junya28nya/PhysicalFlick/readme.md

# 物理フリックキーボード

スマホの文字入力で一般的に使われているフリック入力を行える物理キーボード。

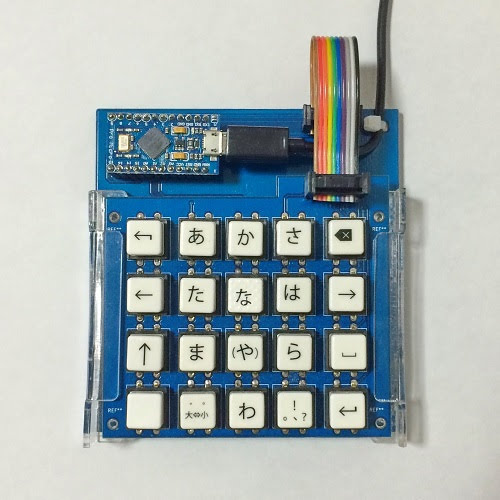
[picture p1: manual/Resources/a_00.jpg]
物理フリックの画像


- [物理フリックキーボード使用動画](https://youtu.be/PQrwTX5ErzM)
## 仕様
- ボタンの押下と上下左右のフリック方向から、かなの入力が行えます。
- アルファベットの入力はできません。Arduinoのプログラムを変更することでアルファベットの入力をできるようにすることは可能です。
- 半角全角の切り替えはできません。使用にはPCのキーボードで全角モードに切り替える必要があります。

### 各キーの説明
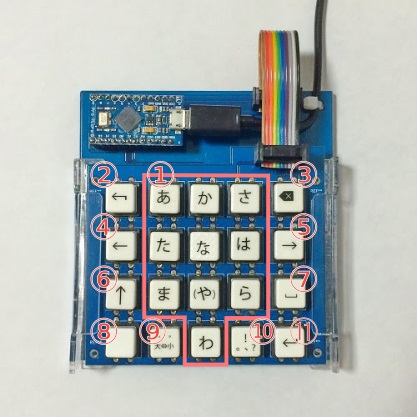
[picture p2: manual/Resources/a_01.jpg]
各キーの説明


|||||
|---|---|---|---|
|①|かな入力をおこなうキー|②|母音を戻るキー。例：い→あ→お|
|③|バックスペース|④|←矢印キー|
|⑤|→矢印キー|⑥|↑矢印キー|
|⑦|スペースキー|⑧|顔文字キー|
|⑨|大小文字切り替えキー|⑩|。、！？キー|
|⑪|Enterキー|　|　|

## development
[development](https://github.com/junya28nya/PhysicalFlick/blob/master/development/development.md)  
プログラム、回路図について。

## manual
[組み立て方](https://github.com/junya28nya/PhysicalFlick/blob/master/manual/HowtoAssembly.md)  
組み立て方について。
