junya28nya/PhysicalFlick/development/development.md

使用マイコン：Pro-micro

## プログラム
[flick.ino](https://github.com/junya28nya/PhysicalFlick/blob/master/development/flick/flick.ino):メインプログラム  
[func.ino](https://github.com/junya28nya/PhysicalFlick/blob/master/development/flick/func.ino):関数群  

## 回路図
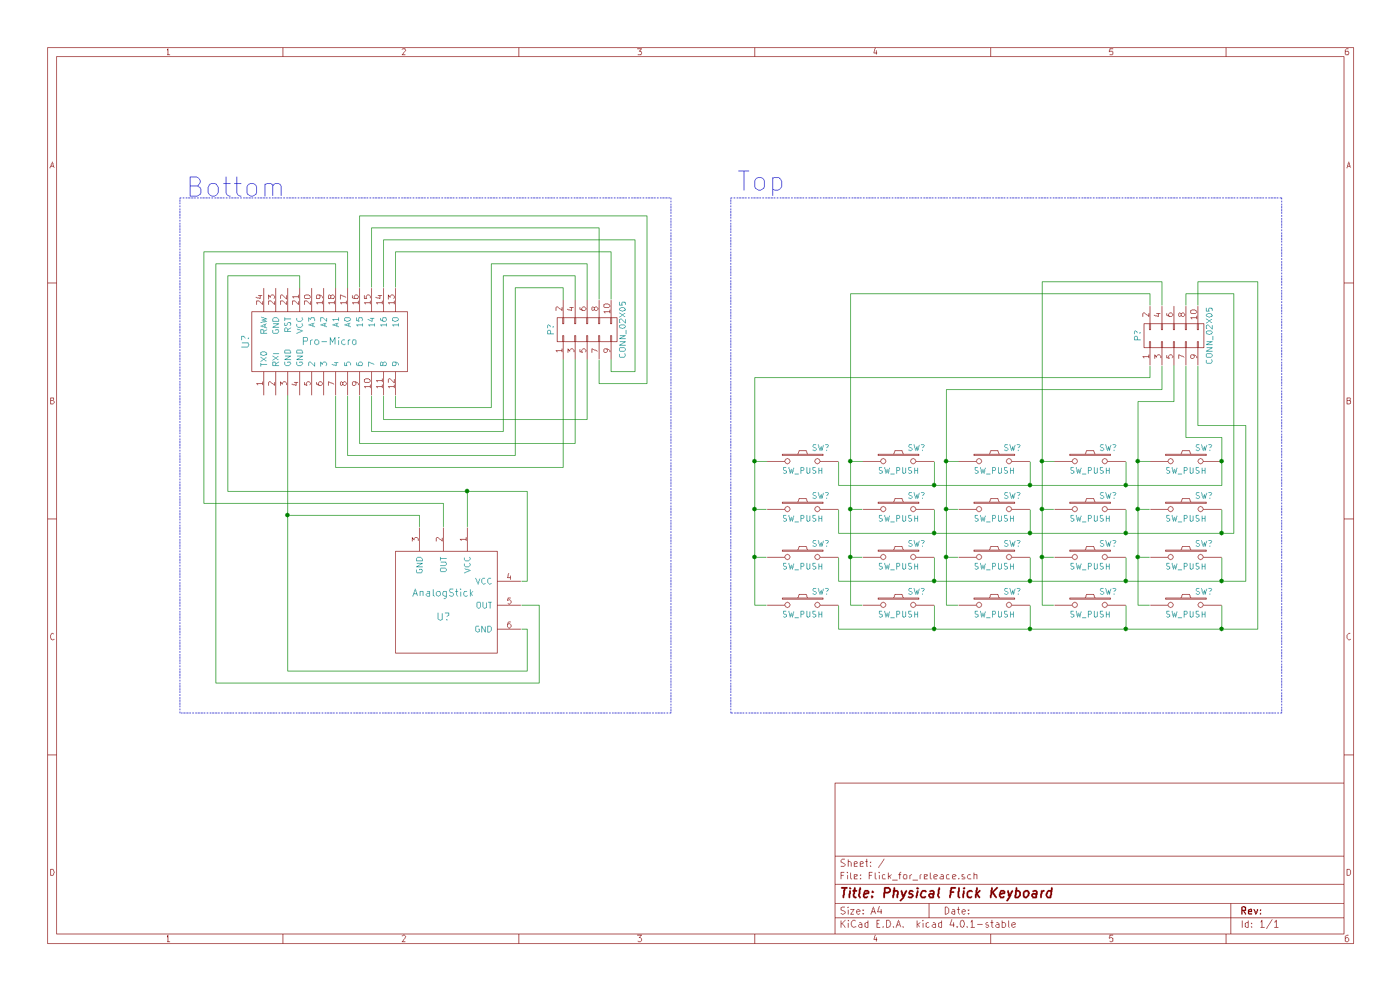
[picture p3: development/Resources/circuit.png]
回路
