junya28nya/PhysicalFlick/manual/HowtoAssembly.md

# 物理フリックキーボード組み立て手順

[仕様や各キーの説明についてはこちら](https://github.com/junya28nya/PhysicalFlick/blob/master/readme.md)

## 注意点
基板の側面が鋭くなっている可能性があります。気になる場合はやすり削ってください。  
電子部品は静電気に弱いため、作業前に手を洗う等静電気を除去してください。  
細かい部品があります。紛失しないように注意してください。

## 準備するするもの
- はんだ付けに必要なもの一式
- プラスドライバー

## 内容物の確認
以下の部品がすべてそろっているか確認してから組み立ててください。

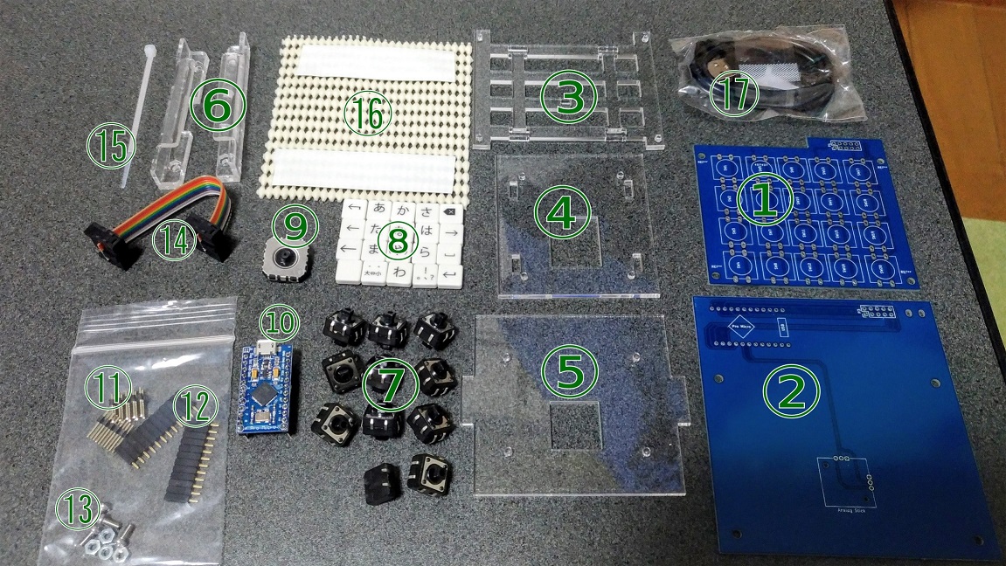
[picture p4: manual/Resources/01.jpg]
内容物一覧


①基板(上)  ②基板(下)  ③フリック機構(上)  ④フリック機構(中)  ⑤フリック機構(下) ⑥サイドパーツ(2つ)  ⑦スイッチ(20個)  ⑧スイッチカバー(20個) ⑨アナログスティック  ⑩pro-micro(マイコン)  ⑪2×5ピンヘッダ(2つ) ⑫1×12ピンソケット(2つ) ⑬ねじとナット(4つ) ⑭コネクタ ⑮結束バンド  ⑯滑り止め ⑰USBケーブル

## 組み立て作業
### ①基板(上)のはんだ付け
- 使用する部品
  - ①基板(上)、⑦スイッチ、⑧スイッチカバー、⑪2×5ピンヘッダ(1つ)

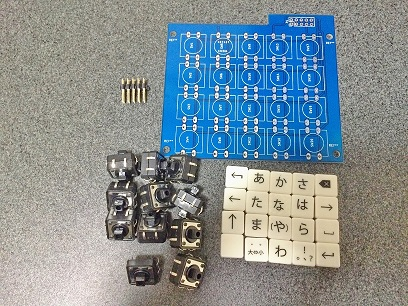
[picture p5: manual/Resources/02_01.jpg]
①基板(上)のはんだ付け部品


| | |
|---|---|
|||
|1-1　スイッチのはんだ付け <br>⑦スイッチを①基板(上)に差し込む <br>　|1-2　裏面 <br> スイッチの足はおらないように注意 <br> (③フリック機構(上)に干渉してしまう)|
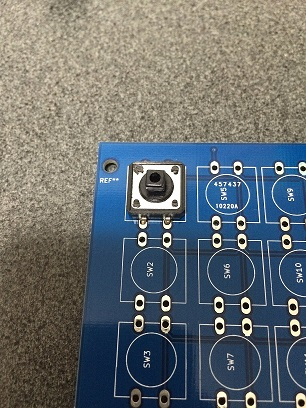
[picture p6: manual/Resources/02_02.jpg]
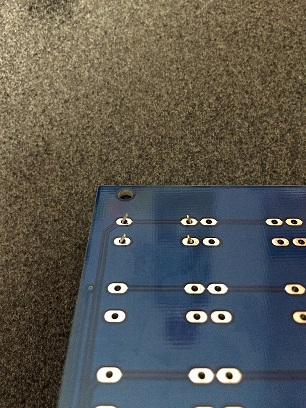
[picture p7: manual/Resources/02_03.jpg]
|||
|1-3 <br> すべてのスイッチを差し込んでから、裏面にはんだ付けを行う|1-4　⑪2×5ピンヘッダのはんだ付け <br> 傾かないように確認しはんだ付けを行う|
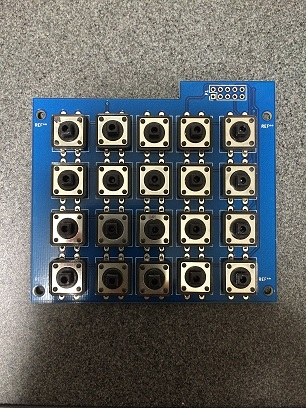
[picture p8: manual/Resources/02_04.jpg]
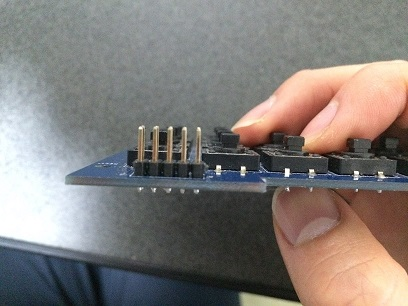
[picture p9: manual/Resources/02_05.jpg]
|||
|1-5 はんだ付け後の画像 <br> 表面|1-6 はんだ付け後の画像 <br> 裏面|
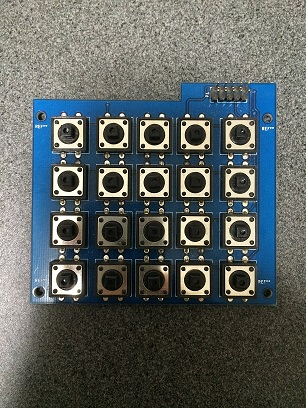
[picture p10: manual/Resources/02_06.jpg]
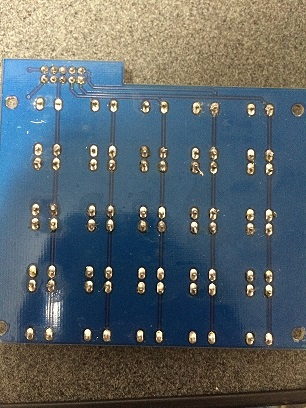
[picture p11: manual/Resources/02_07.jpg]
|||
|1-7　⑧スイッチカバーの取り付け <br> 図の並びでカバーを取り付ける|1-8 基板(上)のはんだ付け作業終了|
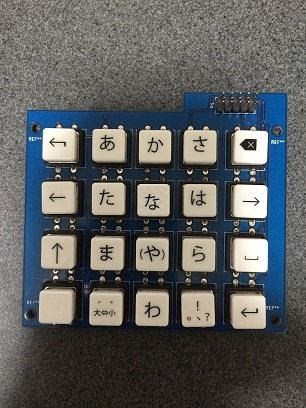
[picture p12: manual/Resources/02_08.jpg]
||　|

### ②基板(下)のはんだ付け
- 使用する部品
  - ②基板(下)、⑩アナログスティック、⑪2×5ピンヘッダ(1つ)、⑫1×12ピンソケット

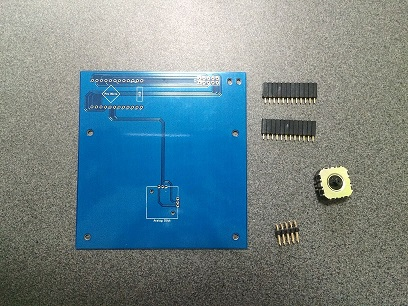
[picture p13: manual/Resources/03_01.jpg]
①基板(下)のはんだ付け部品


| | |
|---|---|
|||
|2-1　②基板(下)の裏表の確認　<br>表面　<br>ひし形に「Pro Micro」と書かれた部分が左上|2-2　②基板(下)の裏表の確認　<br>裏面 <br>白い文字が入っていない面が裏面|
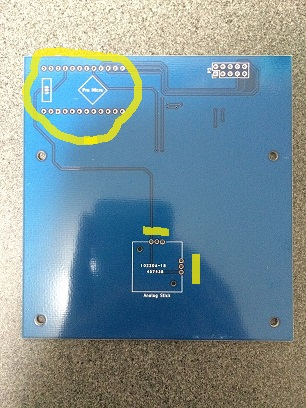
[picture p14: manual/Resources/03_02.jpg]
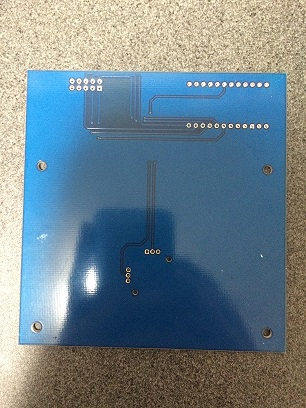
[picture p15: manual/Resources/03_03.jpg]
|||
|2-3　⑩アナログスティックのはんだ付け　<br>基板の表裏に注意して、裏からはんだ付け|2-4　<br>奥まで刺さり、傾いていないことを確認|
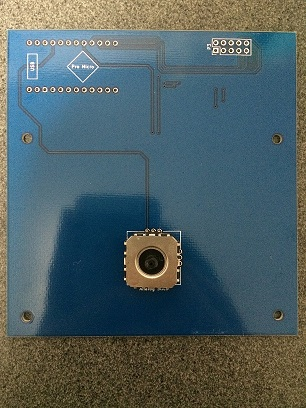
[picture p16: manual/Resources/03_04.jpg]
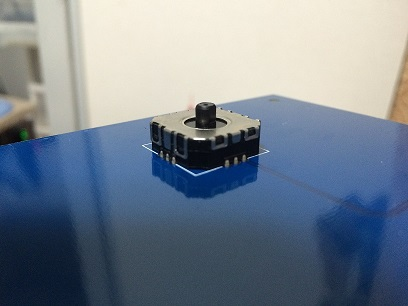
[picture p17: manual/Resources/03_05.jpg]
|||
|2-5　⑪2×5ピンヘッダのはんだ付け <br>傾かないように注意|2-6　⑫ピンソケットのはんだ付け<br>傾かないように注意|
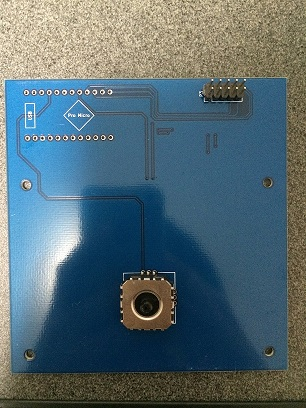
[picture p18: manual/Resources/03_06.jpg]
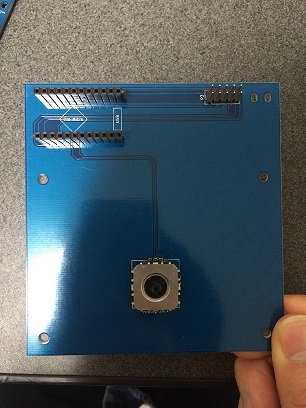
[picture p19: manual/Resources/03_07.jpg]
|||
|2-7　<br>横から傾いてないことを確認|2-8　基板(下)のはんだ付け作業終了<br>|
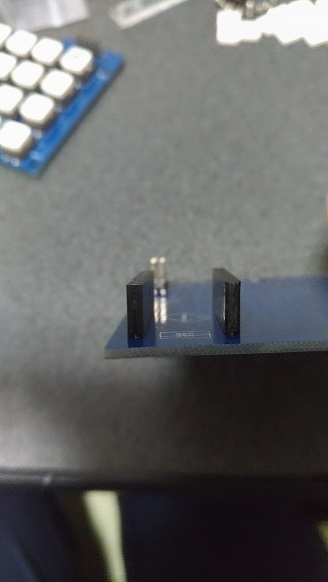
[picture p20: manual/Resources/03_08.jpg]
||　|

### はんだ付けした部品の組み合わせ
- 使用する部品
  - ①基板(上)、②基板(下)、残りすべて

| | |
|---|---|
|||
|3-1　⑥サイドパーツの作成　<br>6角形の穴にナットをはめる<br>2つともはめる|2-2　ナットが入らない場合 <br>下からねじをさし、<br>ねが閉まる力を使いナットをはめる|
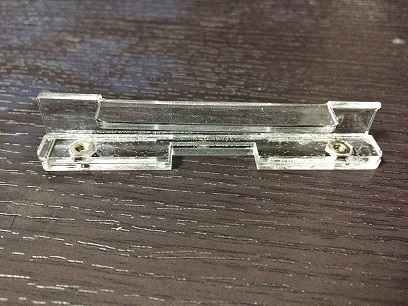
[picture p21: manual/Resources/04_01.jpg]
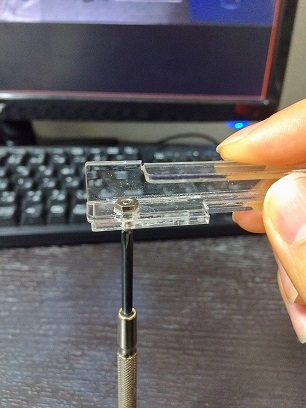
[picture p22: manual/Resources/04_02.jpg]
|||
|3-3　組み立て<br>フリック機構(上)(中)(下)を基板(下)に重ねる<br>アナログスティックの先が穴に通るようにする|2-4　組み立て<br>基板(上)をその上に重ねる<br>四隅の穴に突起がはまるようにする|
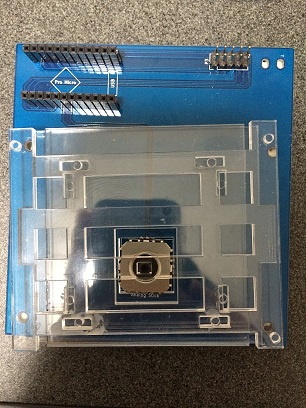
[picture p23: manual/Resources/04_03.jpg]
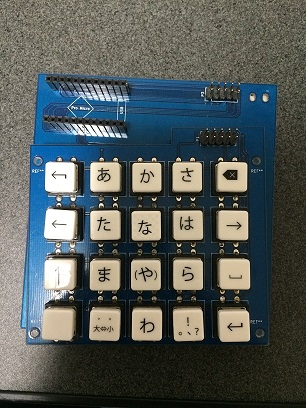
[picture p24: manual/Resources/04_04.jpg]
|||
|3-5　組み立て<br>サイドパーツを取り付ける<br>裏からねじで締める<br>　|2-6　組み立て<br>ここまでを横からみた図<br>基板(上)を動かしても外れないこと、<br>スムーズに動くか確認|
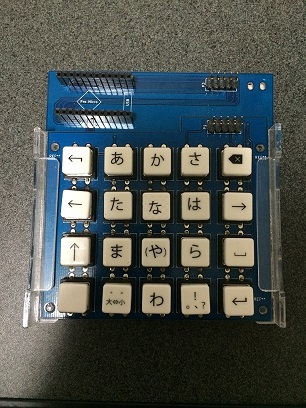
[picture p25: manual/Resources/04_05.jpg]
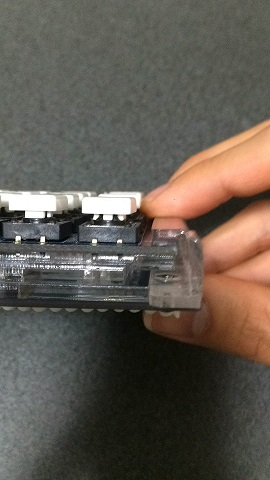
[picture p26: manual/Resources/04_06.jpg]
|||
|3-7　組み立て<br>⑩pro-micro(マイコン)に⑰USBケーブルをさし、<br>ソケットにさす|2-8　組み立て<br>⑭コネクタを取り付ける<br>　|
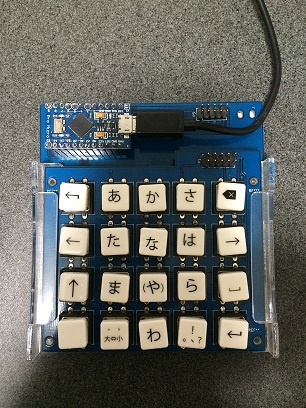
[picture p27: manual/Resources/04_08.jpg]
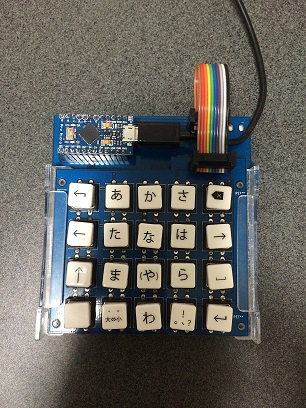
[picture p28: manual/Resources/04_09.jpg]
|||

ここでいったん、PCに接続して動くか確認をする。  
PCに接続し、pro-micro(マイコン)が緑色に点灯、オレンジ色に数回点滅することを確認。  
メモ帳等キーボード入力できるソフトを開き、物理フリックで文字の入力ができることを確認する。  
[参考動画](https://youtu.be/PQrwTX5ErzM)

確認ができたら、PCに接続したUSBを外し、組み立て作業を続ける

| | |
|---|---|
|||
|3-9　組み立て<br>コネクタを外し、基板(下)の右上の穴に⑮結束バンドを通し<br>基板(下)とUSBケーブルを固定する|3-10　組み立て<br>USBケーブルを軽く引っ張っても<br>動かないことを確認し結束バンドを切る　|
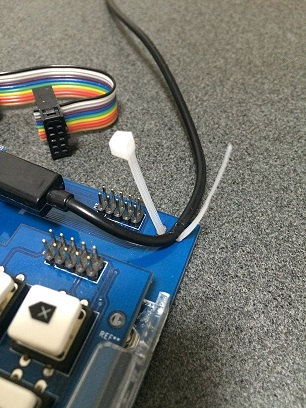
[picture p29: manual/Resources/04_10.jpg]
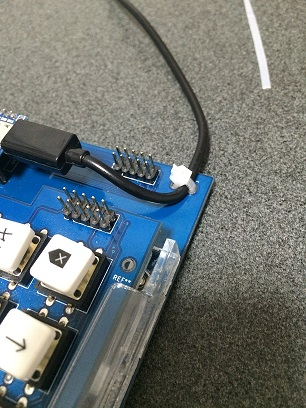
[picture p30: manual/Resources/04_11.jpg]
|||
|3-11　組み立て<br>裏返し、⑯滑り止めを貼る|3-12　完成<br>　|
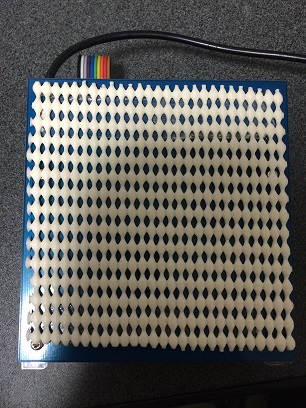
[picture p31: manual/Resources/04_12.jpg]
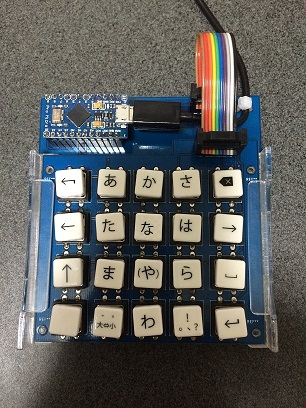
[picture p32: manual/Resources/04_13.jpg]
|||
