junya28nya/PhysicalFlick/manual/Resources/04_07.jpg

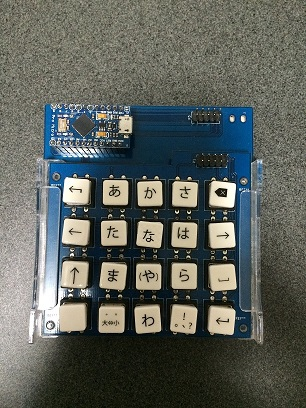
manual/Resources/04_07.jpg
