junya28nya/PhysicalFlick/(commit log)

2021-01-08 ケータイ入力用のプログラムを追加
2021-01-09 ケータイ入力完成
    物理フリックのケータイ入力（トグル入力）のプログラム。
